GadgetReboot/AVR_Programmer/README.md

# AVR_Programmer
Atmel AVR programmer based on Arduino Pro Micro, intended for development into ISP and HVSP using various AVR programming interfaces and protocols.
