GadgetReboot/AVR_Programmer/Sketches/AVR_Prog_HVSP_ATTiny_Fuses/readme.md

Sketch for programming ATTiny85 fuses using high voltage serial programming with a rotary encoder and OLED display on the AVR Programmer PCB.
