GadgetReboot/AVR_Programmer/AVR 1.0 BOM.png

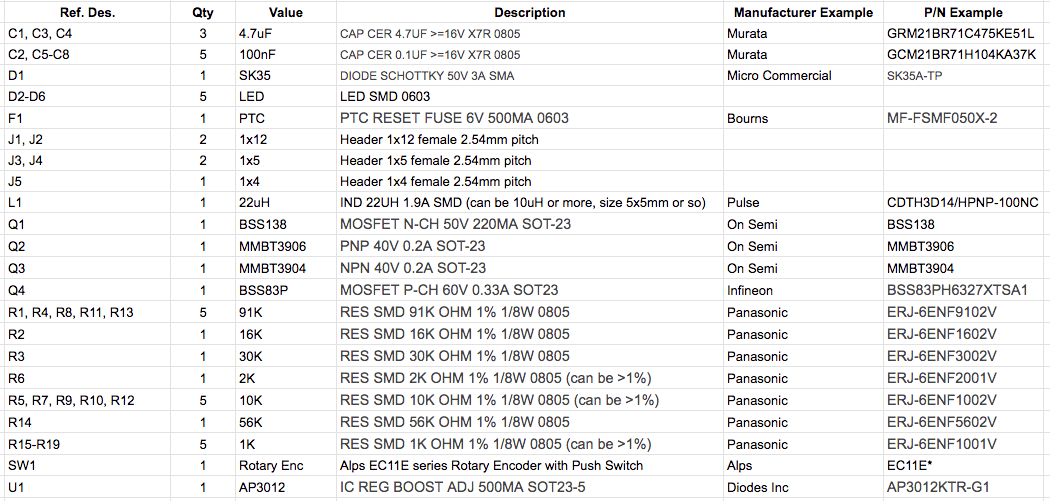
AVR 1.0 BOM.png
