GadgetReboot/AVR_Programmer/GR_AVR_Programmer_Sch_v1.1.pdf

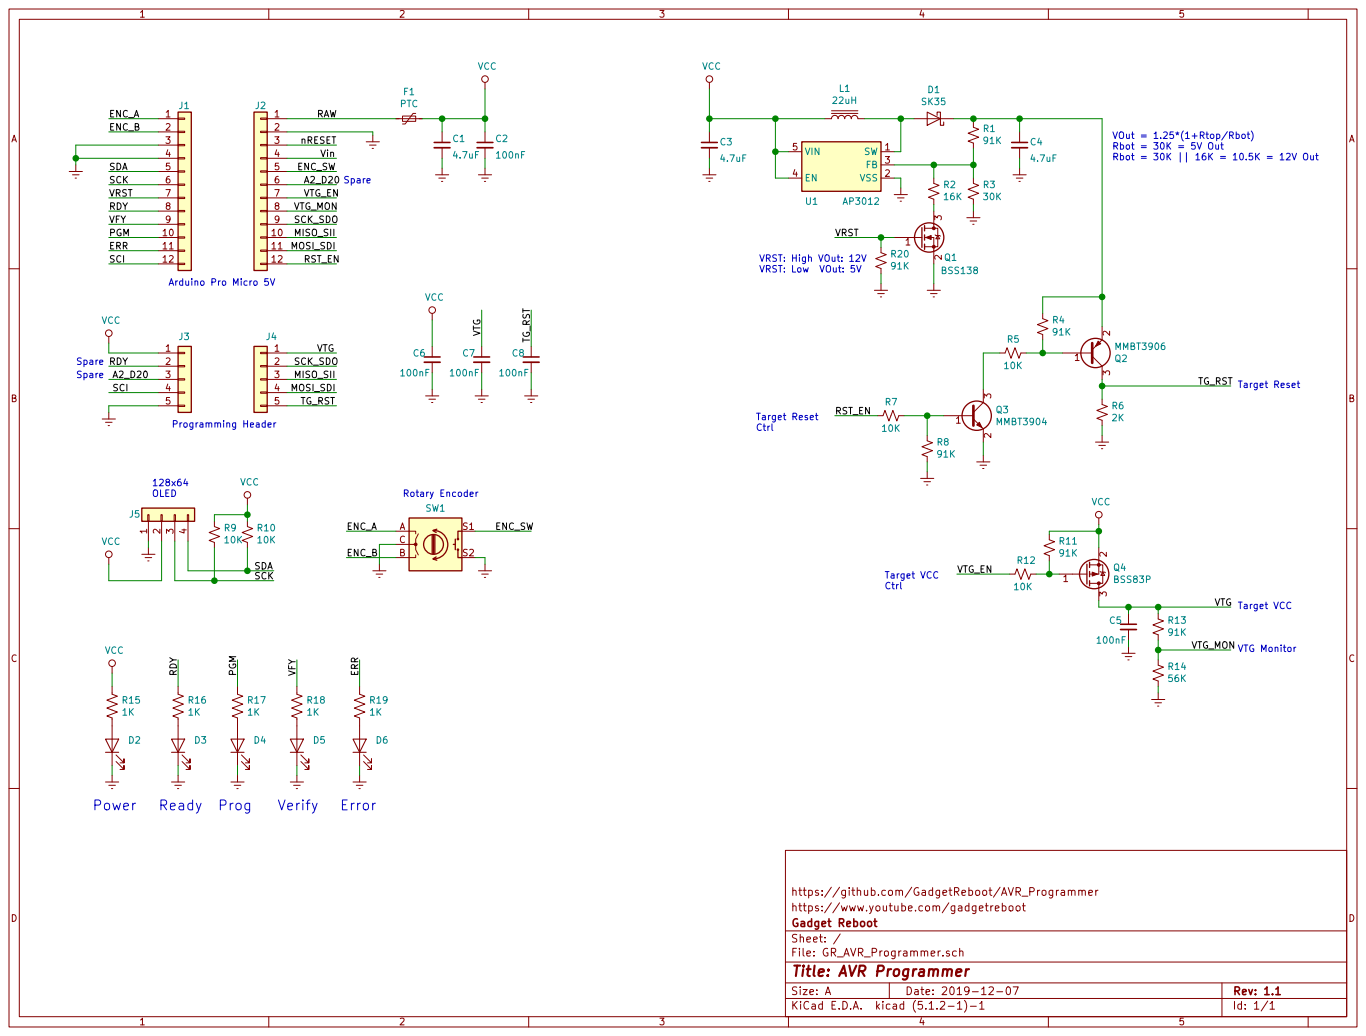
[picture p2: page 1]

Target Reset Ctrl VCC

Programming Header A2_D20 Spare RDY
Spare

https://github.com/GadgetReboot/AVR_Programmer R15

https://www.youtube.com/gadgetreboot
File: GR_AVR_Programmer.sch Sheet: / Gadget Reboot

Id: 1/1 Title: AVR Programmer
