GadgetReboot/AVR_Programmer/KiCAD/GR_AVR_Programmer.kicad_pcb

## KiCad design KiCAD/GR_AVR_Programmer.kicad_pcb (2019-12-09)

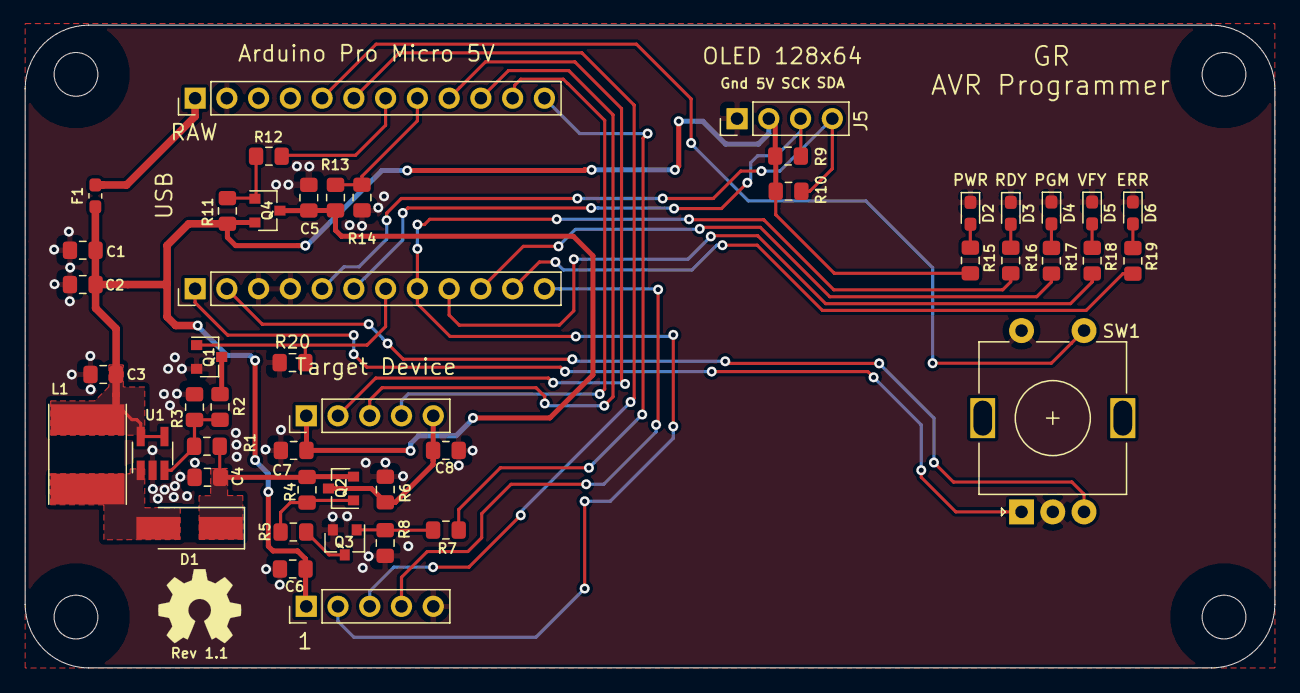
[picture p3: board GR_AVR_Programmer.kicad_pcb from above]

Board: 2 copper layers, 99.9 x 51.4 mm, 47 parts (0 on the bottom side), 36 nets.

Parts:
C1, C3, C4: 4.7uF; C_0805_2012Metric_Pad1.15x1.40mm_HandSolder
C2, C5, C6, C7, C8: 100nF; C_0805_2012Metric_Pad1.15x1.40mm_HandSolder
D1: SK35; D_SMA_Handsoldering
D2, D3, D4, D5, D6: LED; LED_0603_1608Metric_Pad1.05x0.95mm_HandSolder
F1: PTC; Fuse_0603_1608Metric_Pad1.05x0.95mm_HandSolder
J1, J2: Conn_01x12; PinHeader_1x12_P2.54mm_Vertical
J3, J4: Conn_01x05; PinHeader_1x05_P2.54mm_Vertical
J5: Conn_01x04; PinHeader_1x04_P2.54mm_Vertical
L1: 22uH; L_Taiyo-Yuden_NR-60xx_HandSoldering
Q1: BSS138; SOT-23
Q2: MMBT3906; SOT-23
Q3: MMBT3904; SOT-23
Q4: BSS83P; SOT-23
R1, R4, R8, R11, R13, R20: 91K; R_0805_2012Metric_Pad1.15x1.40mm_HandSolder
R2: 16K; R_0805_2012Metric_Pad1.15x1.40mm_HandSolder
R3: 30K; R_0805_2012Metric_Pad1.15x1.40mm_HandSolder
R5, R7, R9, R10, R12: 10K; R_0805_2012Metric_Pad1.15x1.40mm_HandSolder
R6: 2K; R_0805_2012Metric_Pad1.15x1.40mm_HandSolder
R14: 56K; R_0805_2012Metric_Pad1.15x1.40mm_HandSolder
R15, R16, R17, R18, R19: 1K; R_0805_2012Metric_Pad1.15x1.40mm_HandSolder
SW1: Rotary_Encoder_Switch; RotaryEncoder_Alps_EC11E-Switch_Vertical_H20mm
U1: AP3012; SOT-23-5_HandSoldering

Connections:
/A2_D20: J2.6, J3.3
/ENC_A: J1.1, SW1.A
/ENC_B: J1.2, SW1.B
/ENC_SW: J2.5, SW1.S1
/ERR: J1.11, R19.1
/MISO_SII: J2.10, J4.3
/MOSI_SDI: J2.11, J4.4
/PGM: J1.10, R17.1
/RAW: F1.2, J2.1
/RDY: J1.8, J3.2, R16.1
/RST_EN: J2.12, R7.1
/SCI: J1.12, J3.4
/SCK: J1.6, J5.3, R9.1
/SCK_SDO: J2.9, J4.2
/SDA: J1.5, J5.4, R10.1
/TG_RST: C8.1, J4.5, Q2.3, R6.2
/VFY: J1.9, R18.1
/VRST: J1.7, Q1.1, R20.2
/VTG: C5.1, C7.1, J4.1, Q4.3, R13.2
/VTG_EN: J2.7, R12.1
/VTG_MON: J2.8, R13.1, R14.2
GNDREF: C1.2, C2.2, C3.2, C4.2, C5.2, C6.2, C7.2, C8.2, D2.1, D3.1, D4.1, D5.1, D6.1, J1.3, J1.4, J2.2, J3.5, J5.1, Q1.2, Q3.2, R3.1, R6.1, R8.1, R14.1, R20.1, SW1.C, SW1.S2, U1.2
unnamed: C4.1, D1.1, Q2.2, R1.2, R4.2
unnamed: D1.2, L1.2, U1.1
unnamed: D2.2, R15.2
unnamed: D3.2, R16.2
unnamed: D4.2, R17.2
unnamed: D5.2, R18.2
unnamed: D6.2, R19.2
unnamed: Q1.3, R2.1
unnamed: Q2.1, R4.1, R5.2
unnamed: Q3.1, R7.2, R8.2
unnamed: Q3.3, R5.1
unnamed: Q4.1, R11.1, R12.2
unnamed: R1.1, R2.2, R3.2, U1.3
VCC: C1.1, C2.1, C3.1, C6.1, F1.1, J3.1, J5.2, L1.1, Q4.2, R9.2, R10.2, R11.2, R15.1, U1.4, U1.5
