GadgetReboot/AVR_Programmer/ATTiny85_HVSP_Wiring.jpg

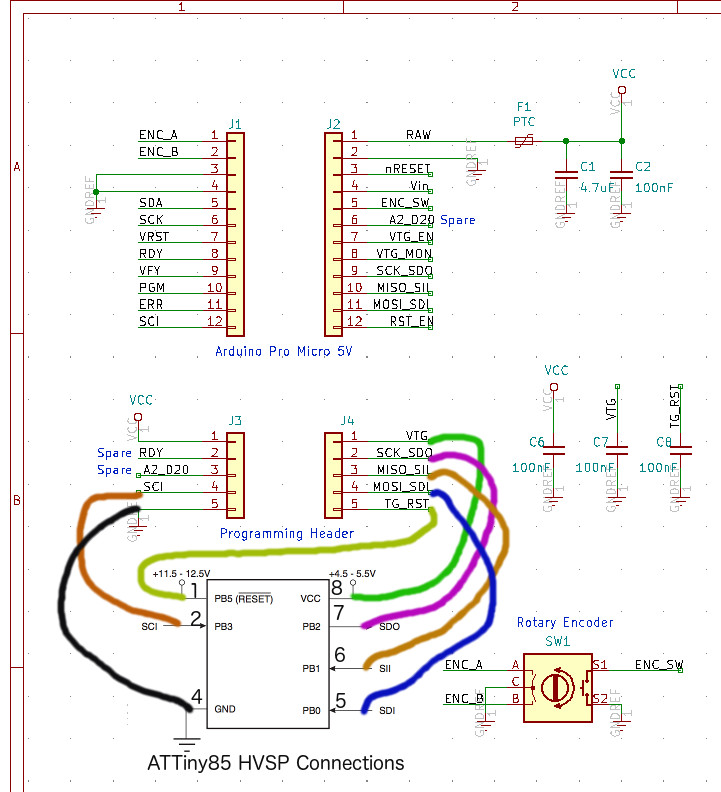
ATTiny85_HVSP_Wiring.jpg
