GadgetReboot/AVR_Programmer/ATTiny85_ISP_Wiring.jpg

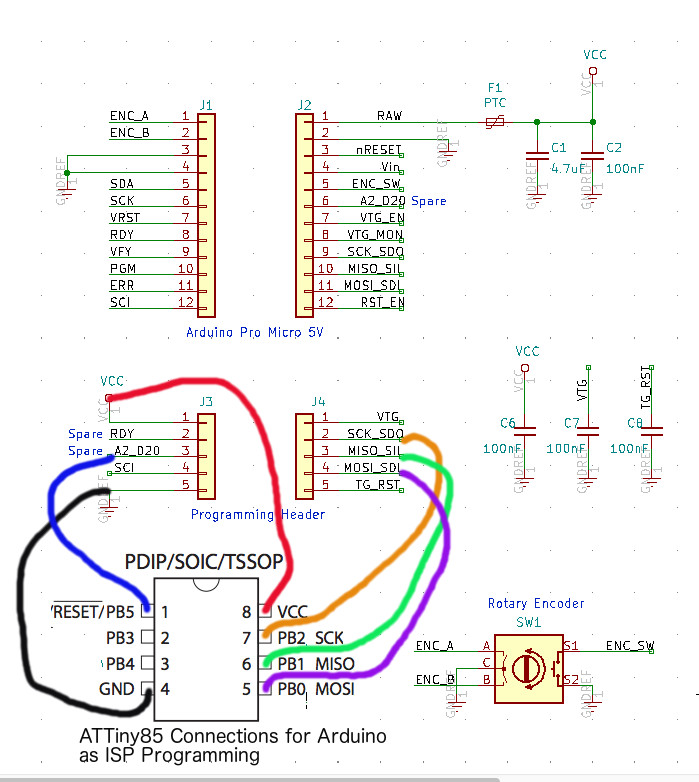
ATTiny85_ISP_Wiring.jpg
